botmayank/haathi_cam/kicad/README.md

# haathi_cam
NXP i.MXRT1050 based camera to set up an early warning system for villages detecting wild elephants in rural India.

This folder contains KiCAD hardware design files.
