botmayank/haathi_cam/docs/haathi_block.png

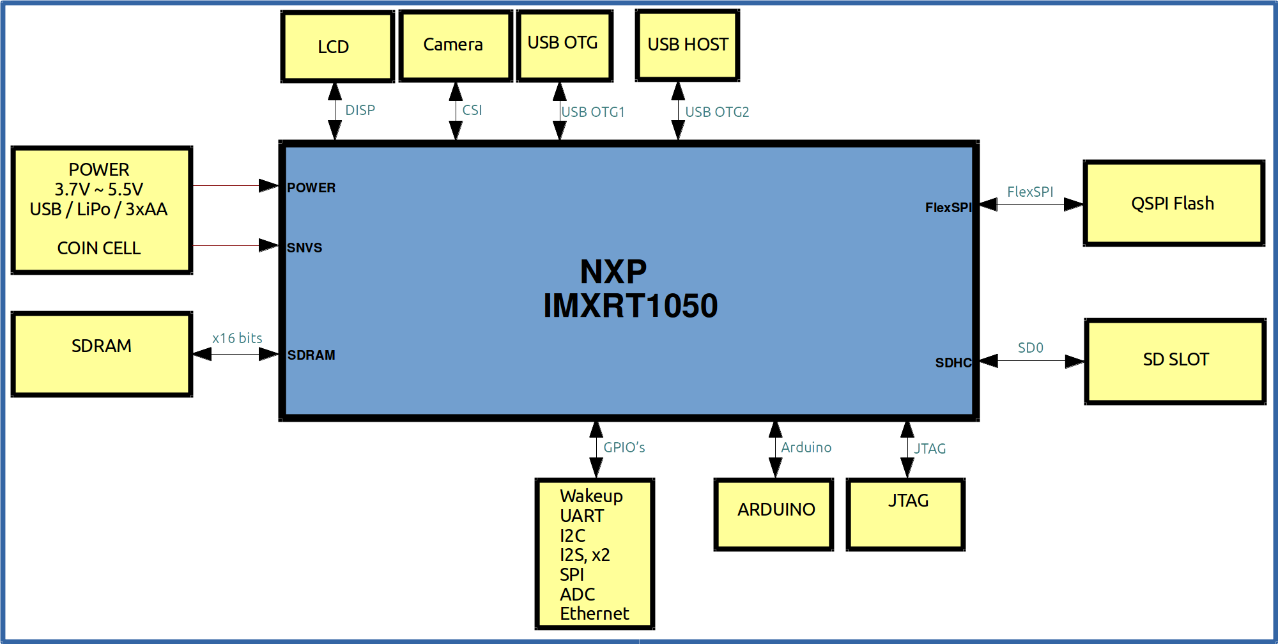
docs/haathi_block.png
