botmayank/haathi_cam/kicad/pdf/haathi.pdf

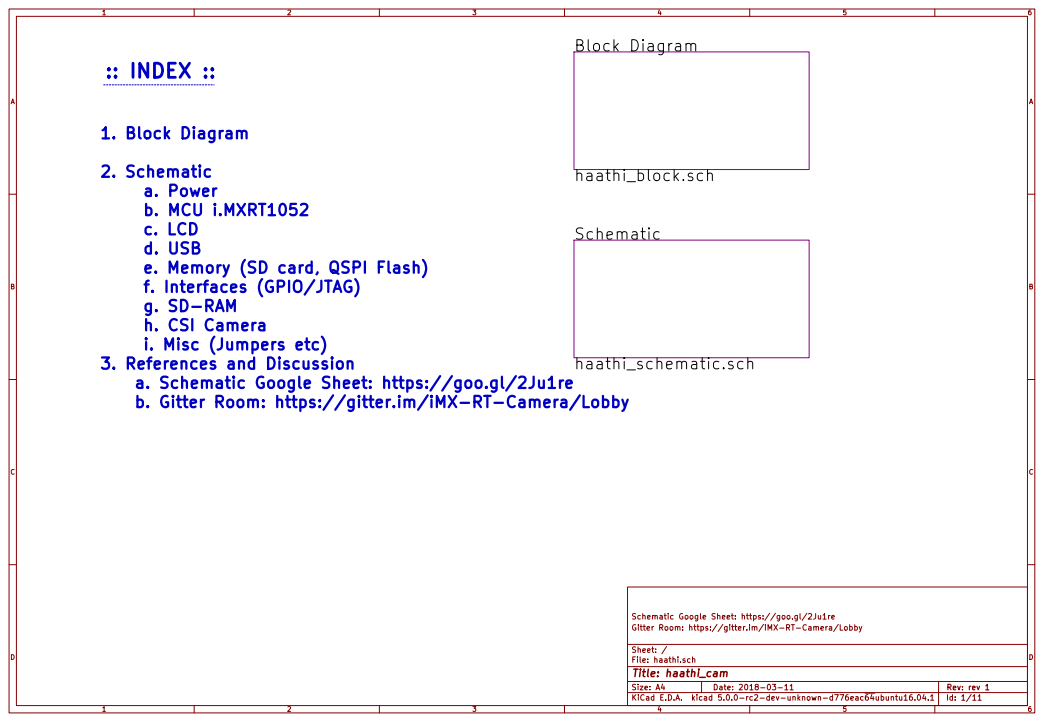
[picture p2: page 1]

2. Schematic
a. Power
b. MCU i.MXRT1052
c. LCD
d. USB
e. Memory (SD card, QSPI Flash)
f. Interfaces (GPIO/JTAG)
g. SD-RAM
h. CSI Camera
i. Misc (Jumpers etc)
3. References and Discussion
a. Schematic Google Sheet: https://goo.gl/2Ju1re
b. Gitter Room: https://gitter.im/iMX-RT-Camera/Lobby

Schematic Google Sheet: https://goo.gl/2Ju1re
File: haathi.sch Sheet: / Gitter Room: https://gitter.im/iMX-RT-Camera/Lobby

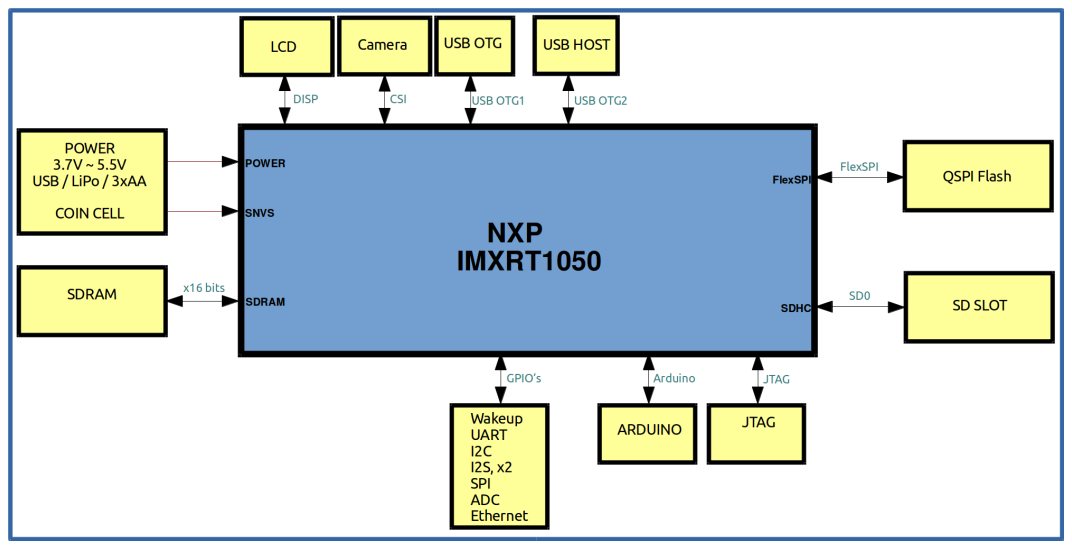
[picture p3: page 2]

Schematic Google Sheet: https://goo.gl/2Ju1re
Gitter Room: https://gitter.im/iMX-RT-Camera/Lobby

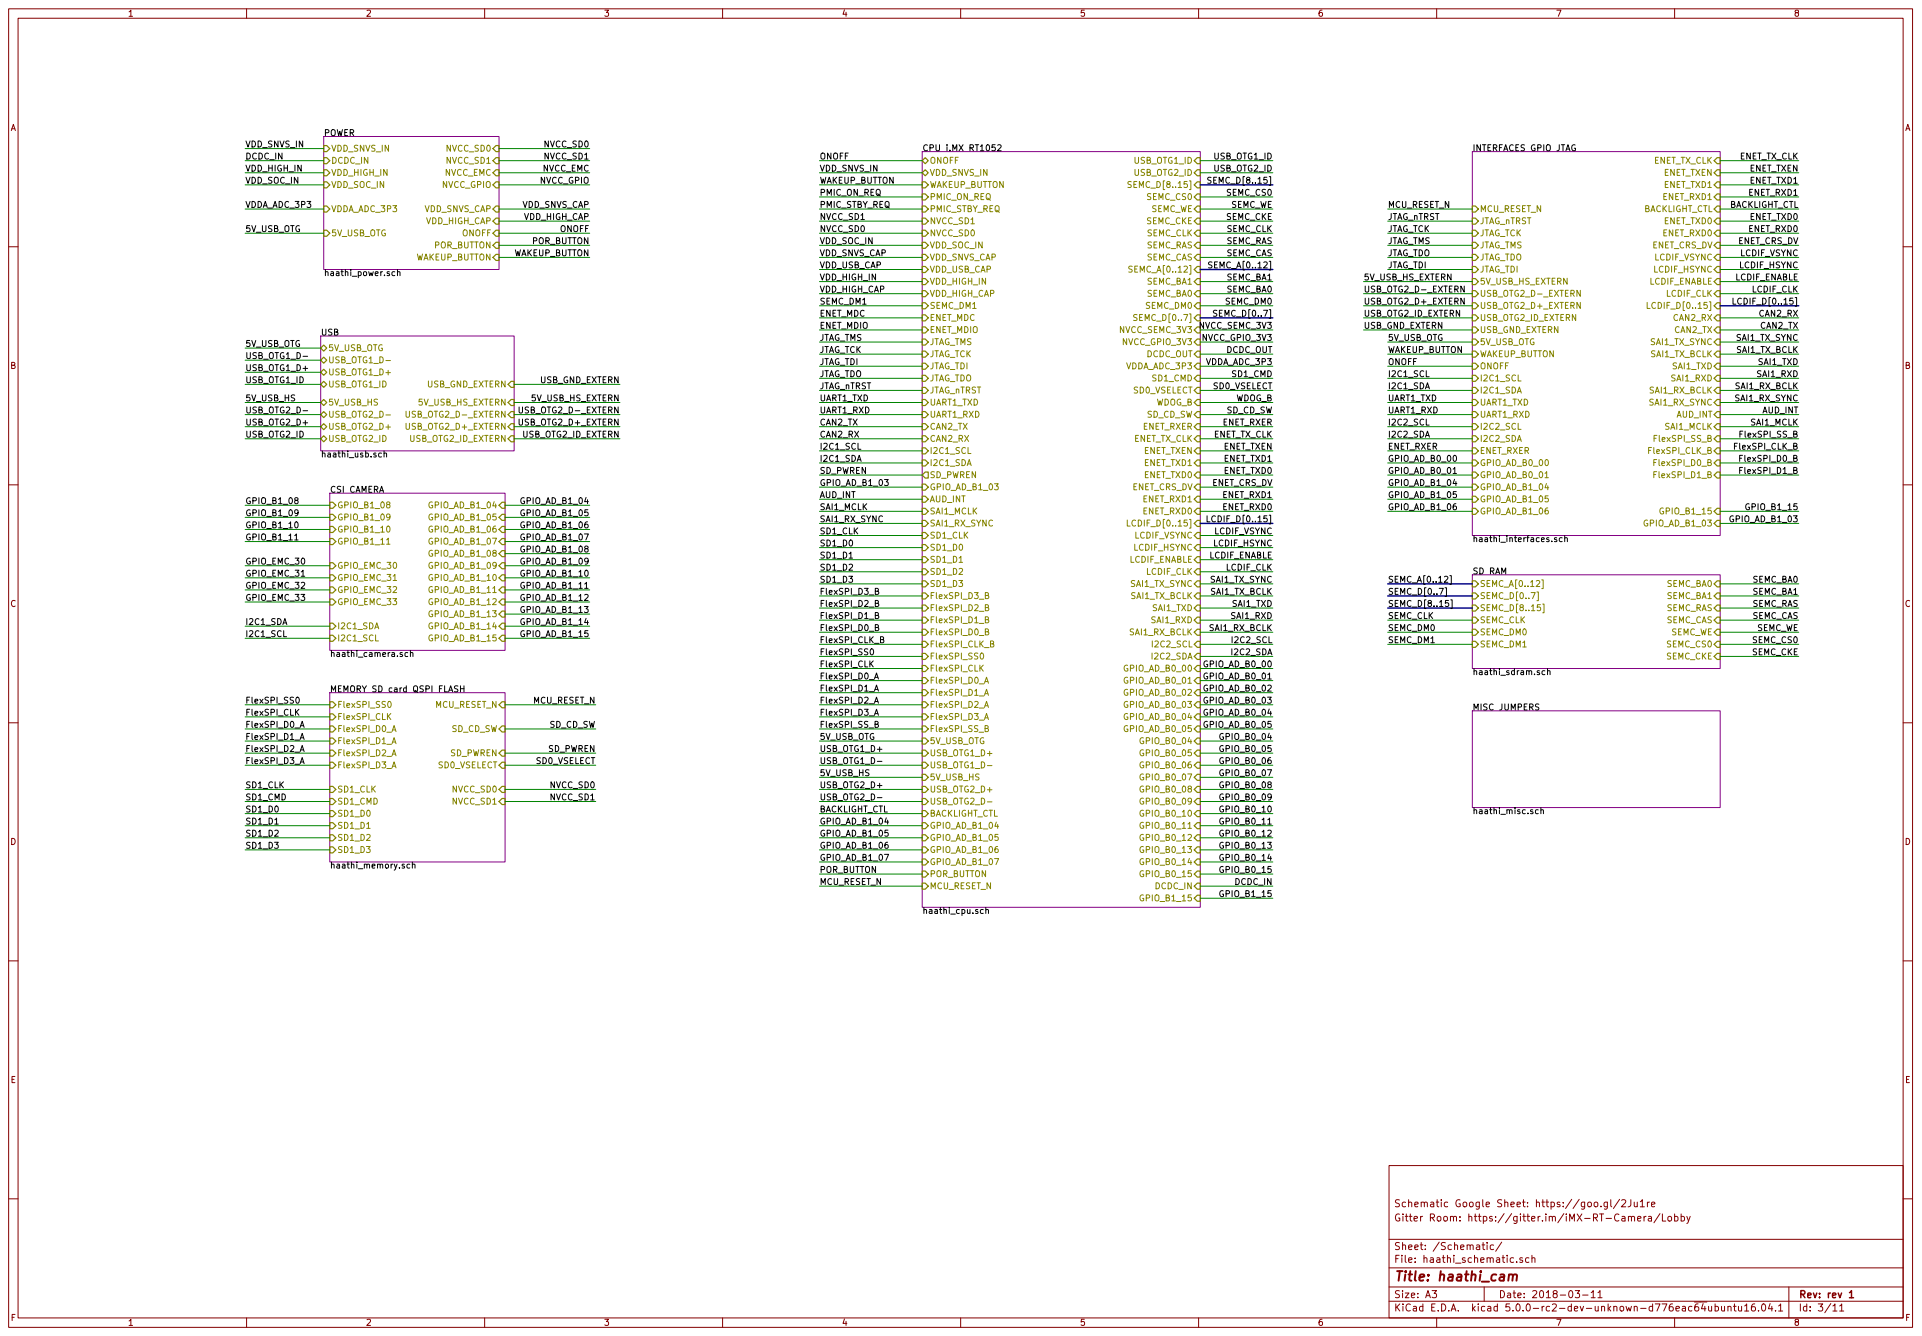
[picture p4: page 3]

GPIO_B1_15 MEMORY SD card QSPI FLASH
FlexSPI_SS0 FlexSPI_CLK

Schematic Google Sheet: https://goo.gl/2Ju1re
File: haathi_schematic.sch Sheet: /Schematic/ Gitter Room: https://gitter.im/iMX-RT-Camera/Lobby

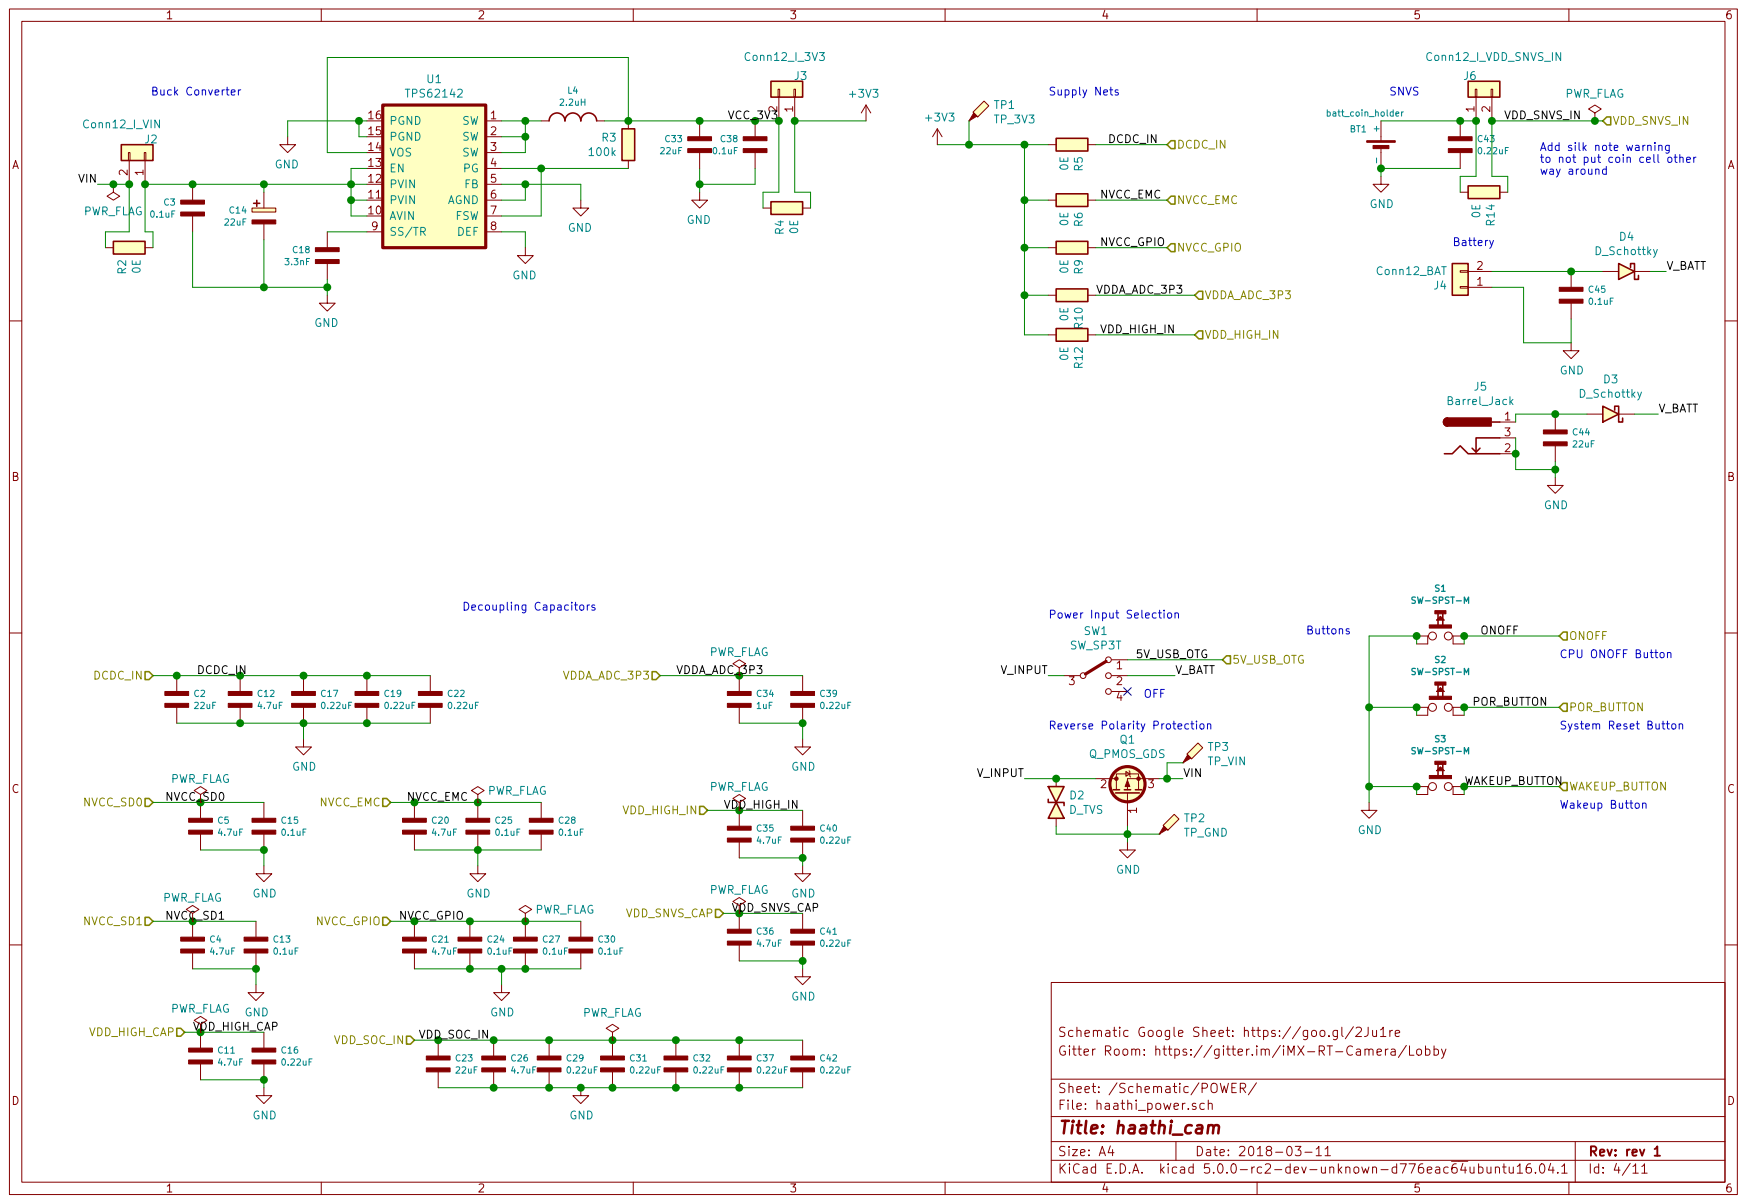
[picture p5: page 4]

Add silk note warning
to not put coin cell other
way around

Schematic Google Sheet: https://goo.gl/2Ju1re
File: haathi_power.sch Sheet: /Schematic/POWER/ Gitter Room: https://gitter.im/iMX-RT-Camera/Lobby

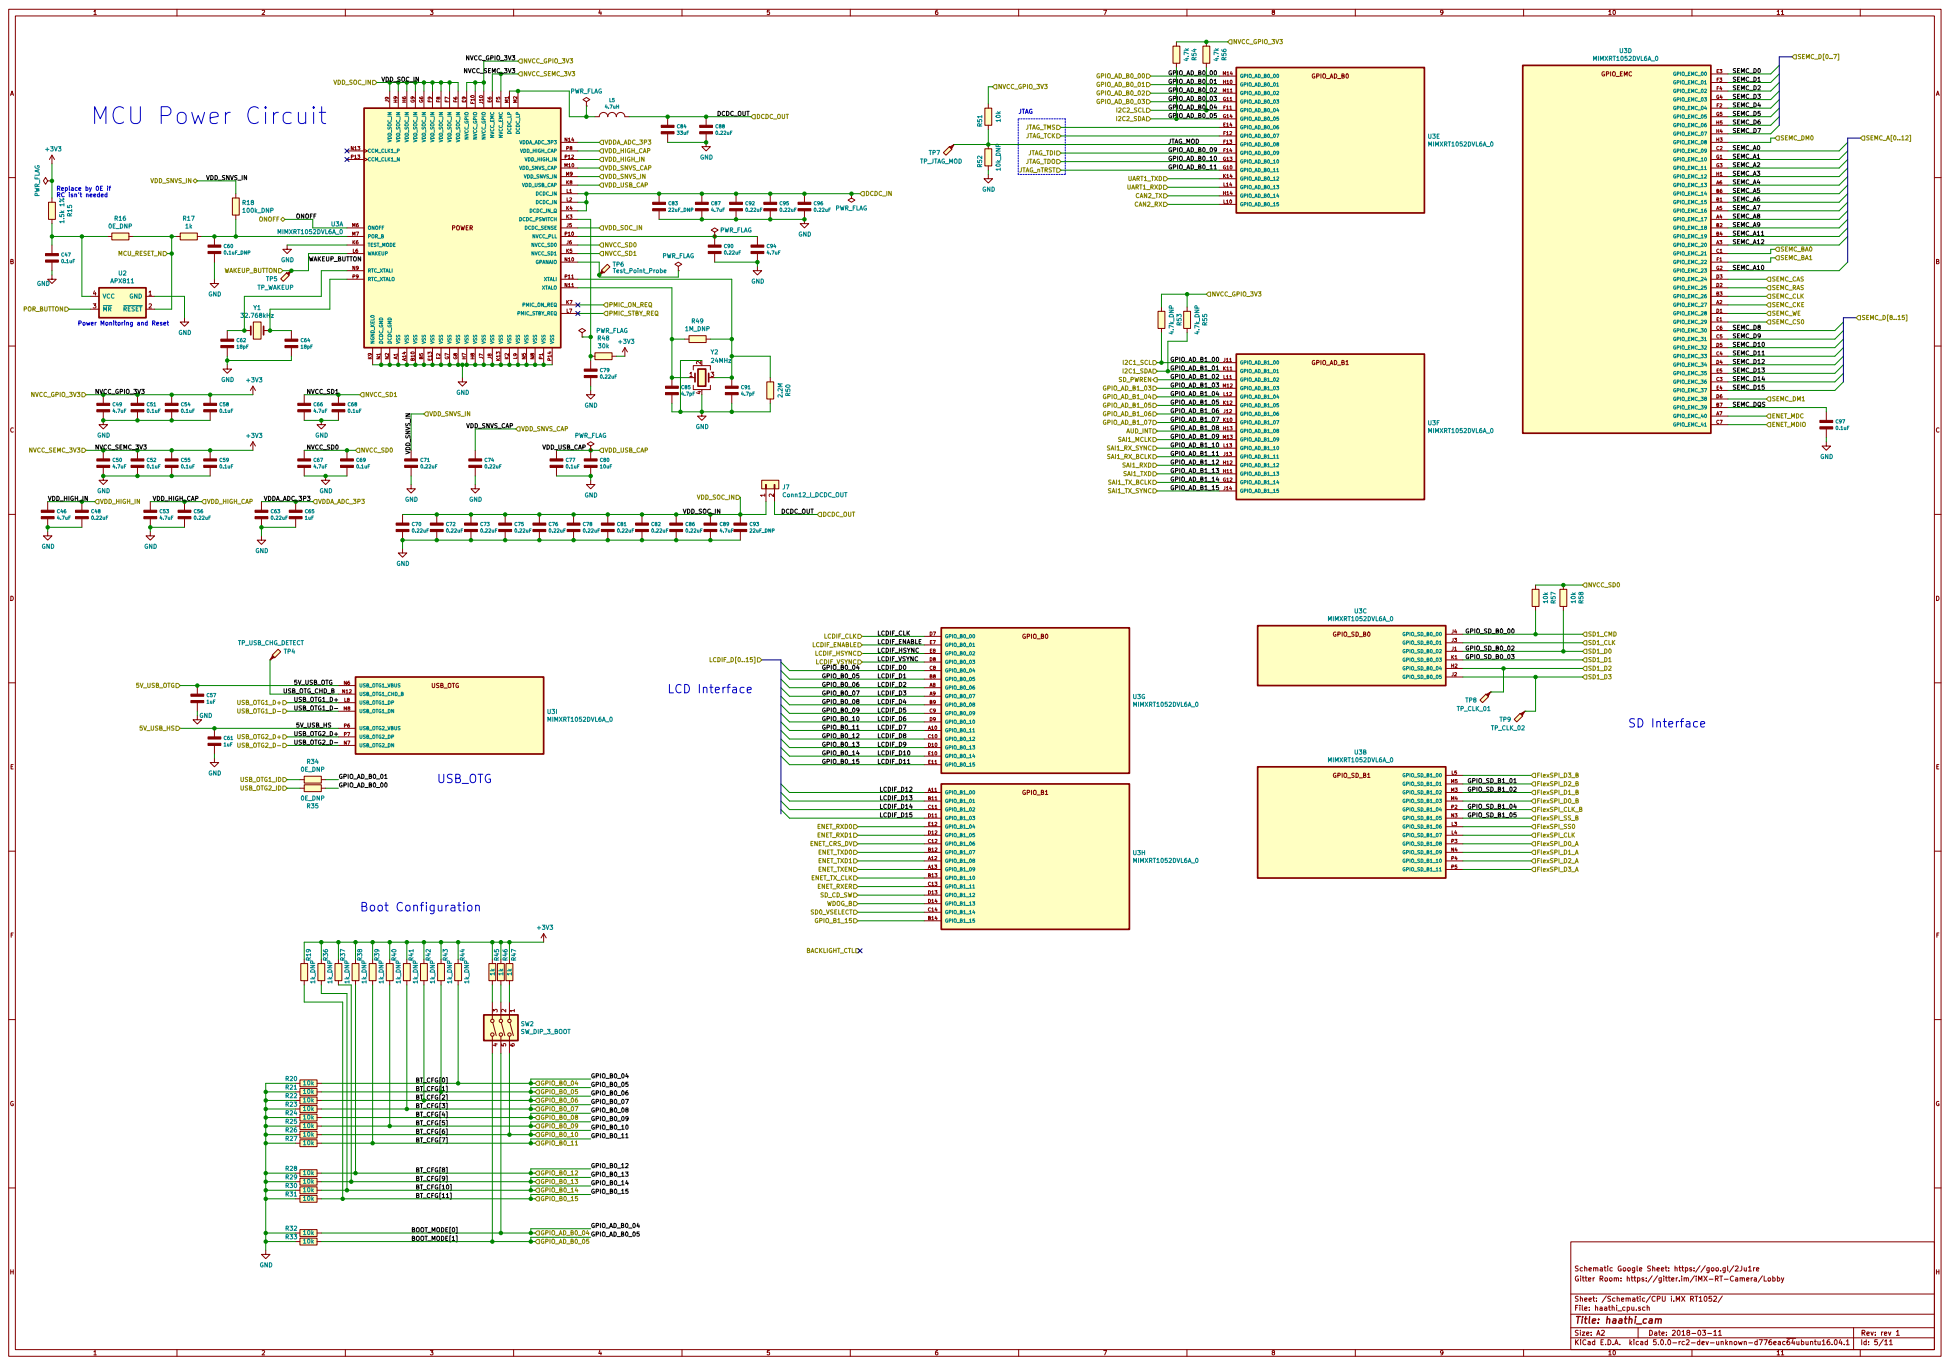
[picture p6: page 5]

Power Monitoring and Reset

Schematic Google Sheet: https://goo.gl/2Ju1re
File: haathi_cpu.sch Sheet: /Schematic/CPU i.MX RT1052/ Gitter Room: https://gitter.im/iMX-RT-Camera/Lobby

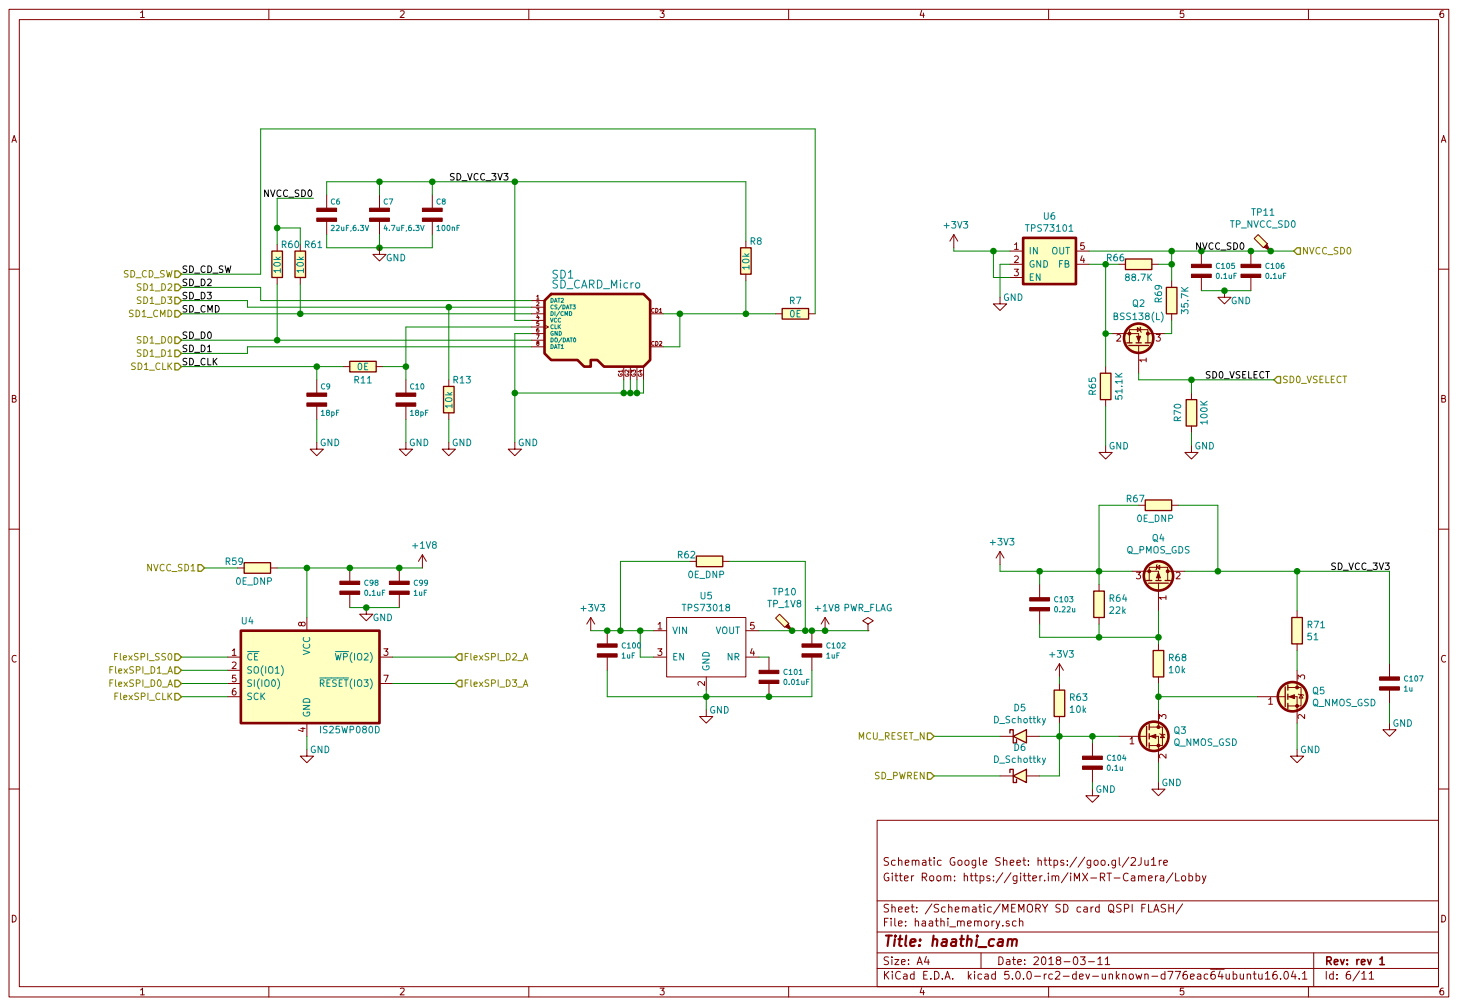
[picture p7: page 6]

2 EN 3 NR 4 VOUT 5 U5 TPS73018 GND

4 SI(IO0) 5 SCK 6 RESET(IO3) 7 VCC

Schematic Google Sheet: https://goo.gl/2Ju1re
Gitter Room: https://gitter.im/iMX-RT-Camera/Lobby

Sheet: /Schematic/MEMORY SD card QSPI FLASH/
File: haathi_memory.sch
Id: 6/11 Title: haathi_cam

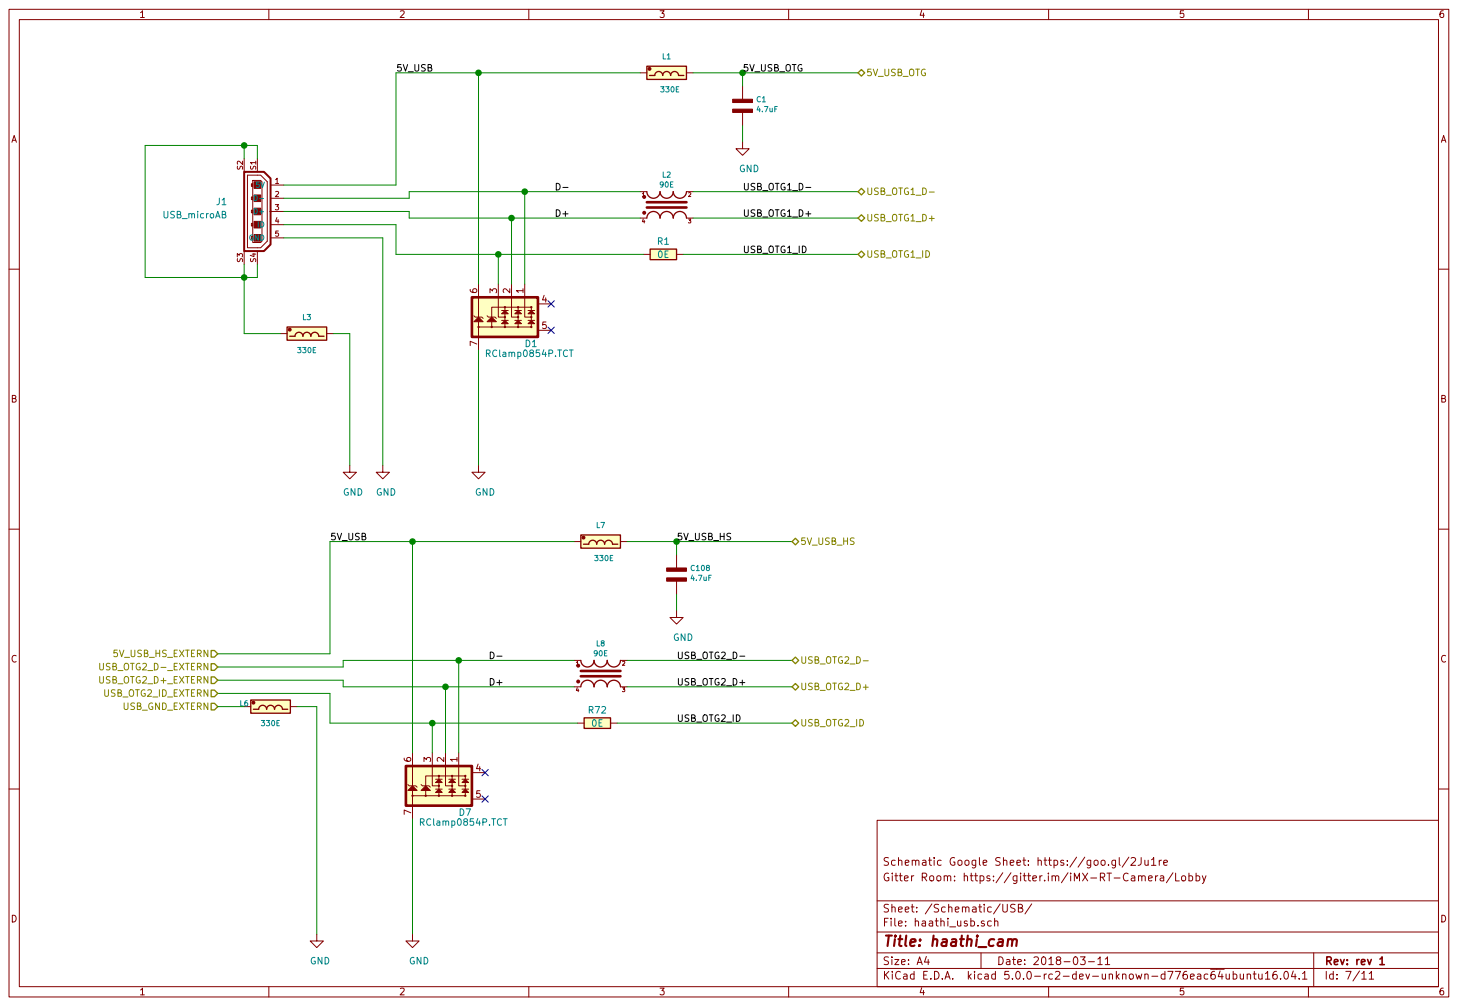
[picture p8: page 7]

Schematic Google Sheet: https://goo.gl/2Ju1re
File: haathi_usb.sch Sheet: /Schematic/USB/ Gitter Room: https://gitter.im/iMX-RT-Camera/Lobby

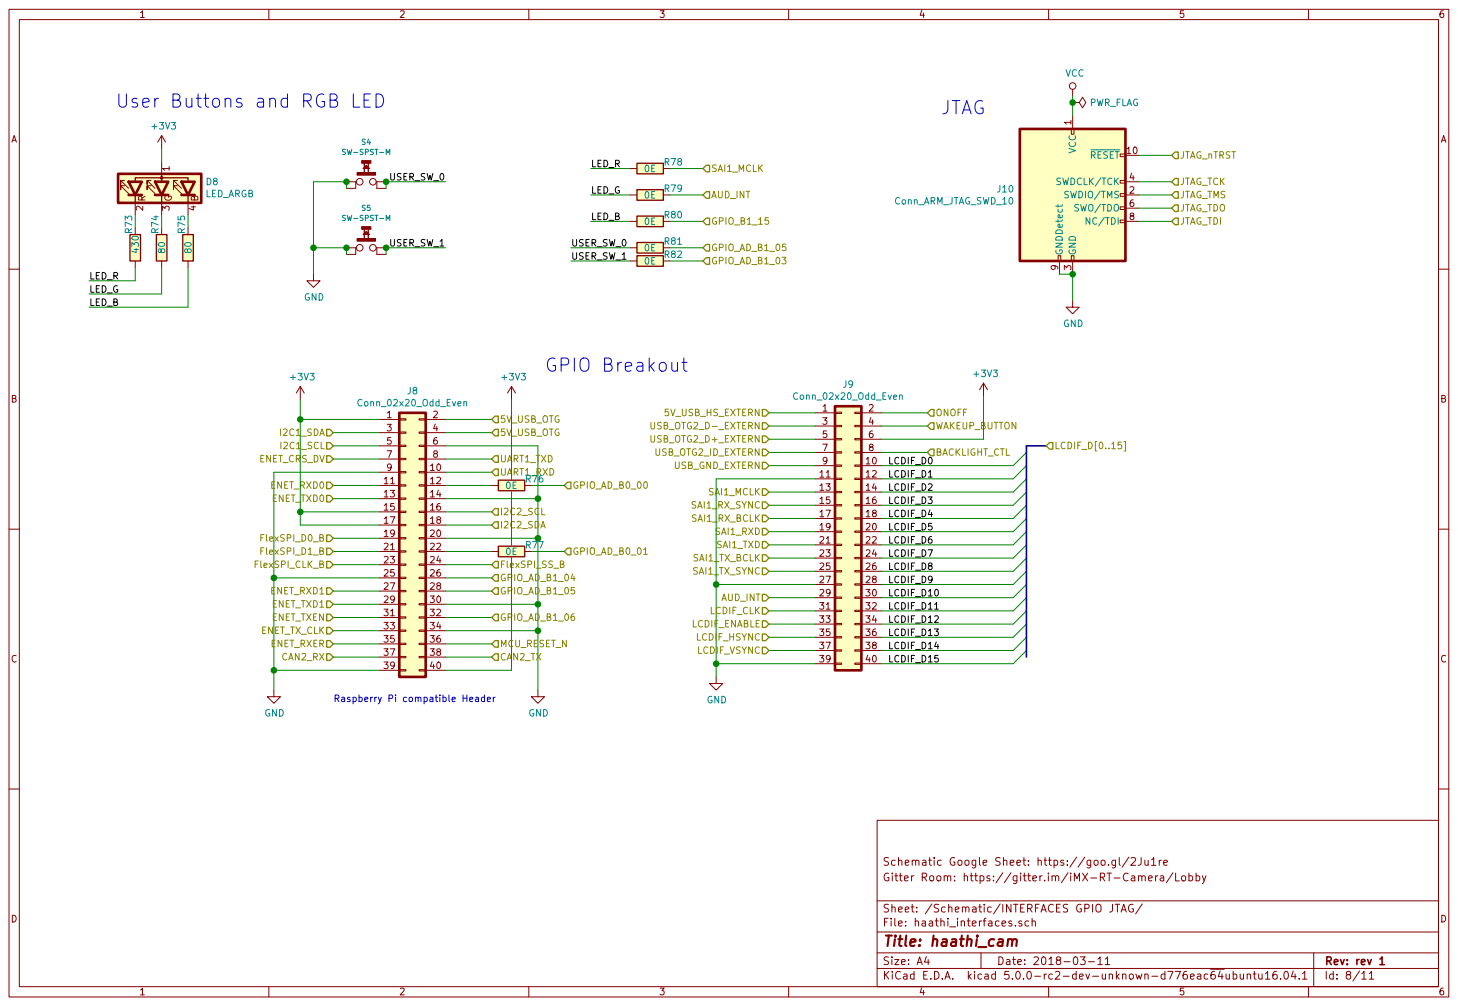
[picture p9: page 8]

1 RESET 10 SWDIO/TMS 2 GND

3 SWDCLK/TCK 4 SWO/TDO 6 NC/TDI 8 GNDDetect 9

Raspberry Pi compatible Header

Schematic Google Sheet: https://goo.gl/2Ju1re
File: haathi_interfaces.sch Sheet: /Schematic/INTERFACES GPIO JTAG/ Gitter Room: https://gitter.im/iMX-RT-Camera/Lobby

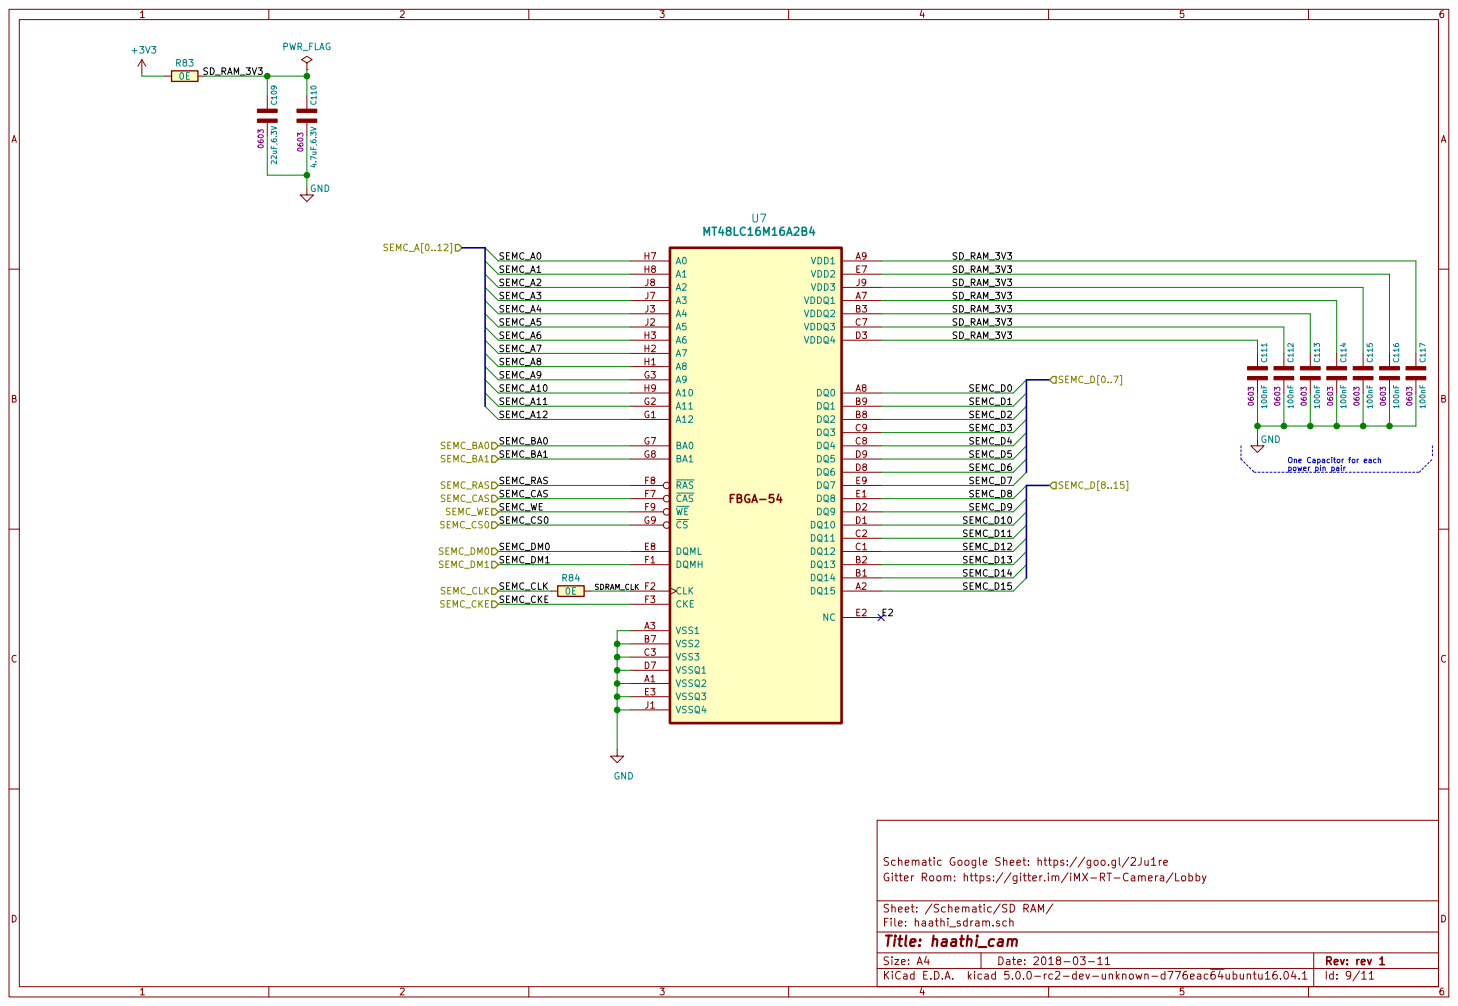
[picture p10: page 9]

Schematic Google Sheet: https://goo.gl/2Ju1re FBGA-54

File: haathi_sdram.sch Sheet: /Schematic/SD RAM/ Gitter Room: https://gitter.im/iMX-RT-Camera/Lobby

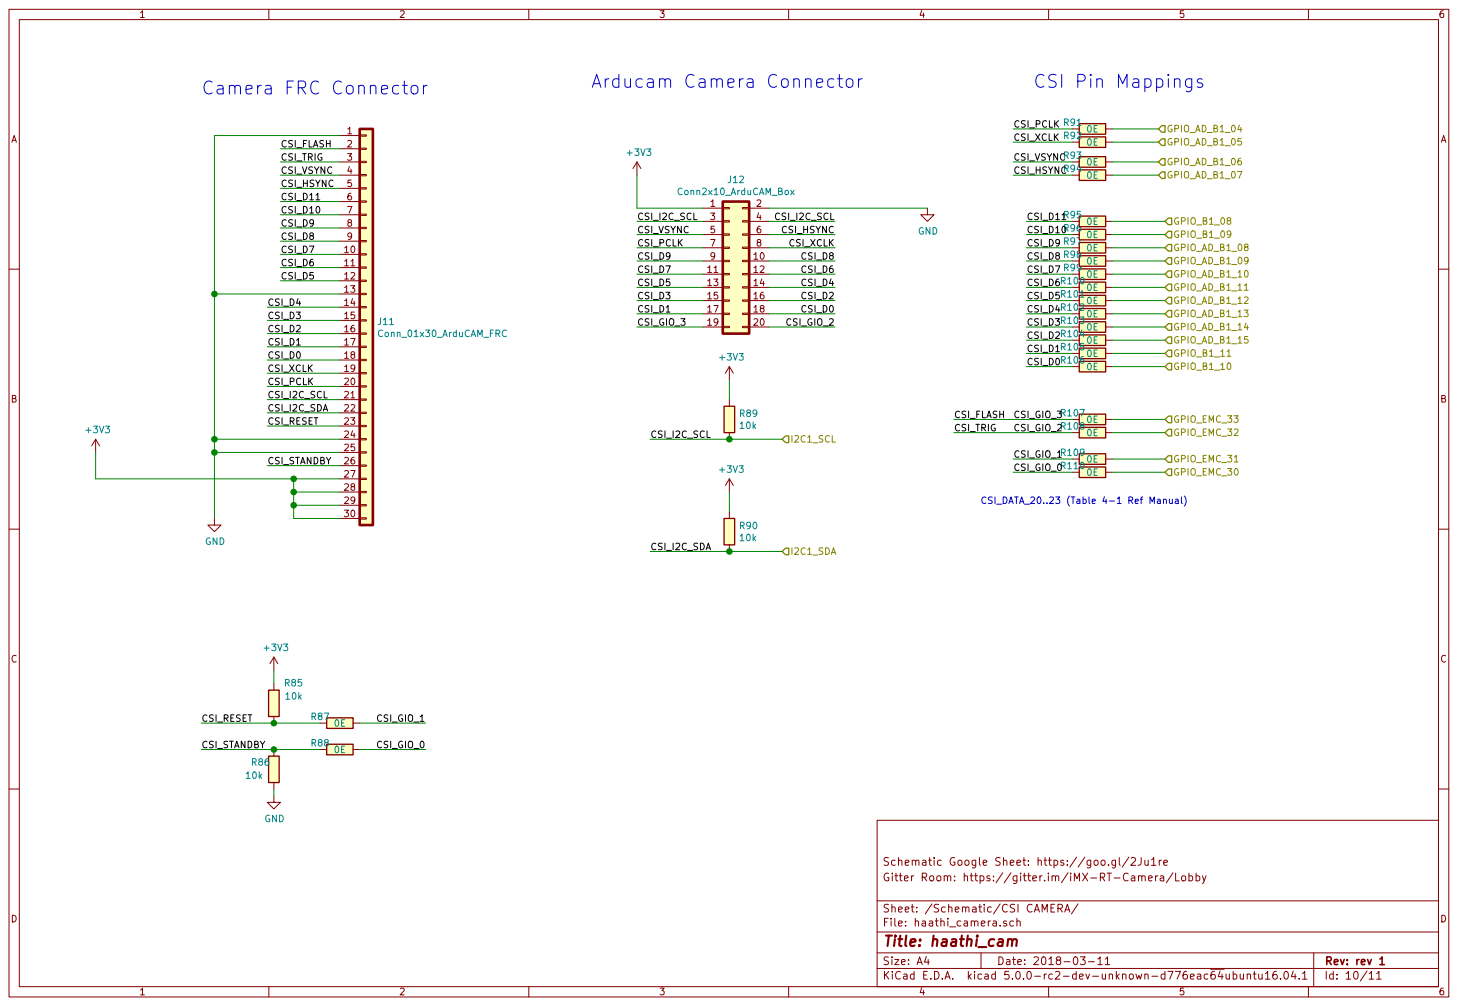
[picture p11: page 10]

Schematic Google Sheet: https://goo.gl/2Ju1re
File: haathi_camera.sch Sheet: /Schematic/CSI CAMERA/ Gitter Room: https://gitter.im/iMX-RT-Camera/Lobby

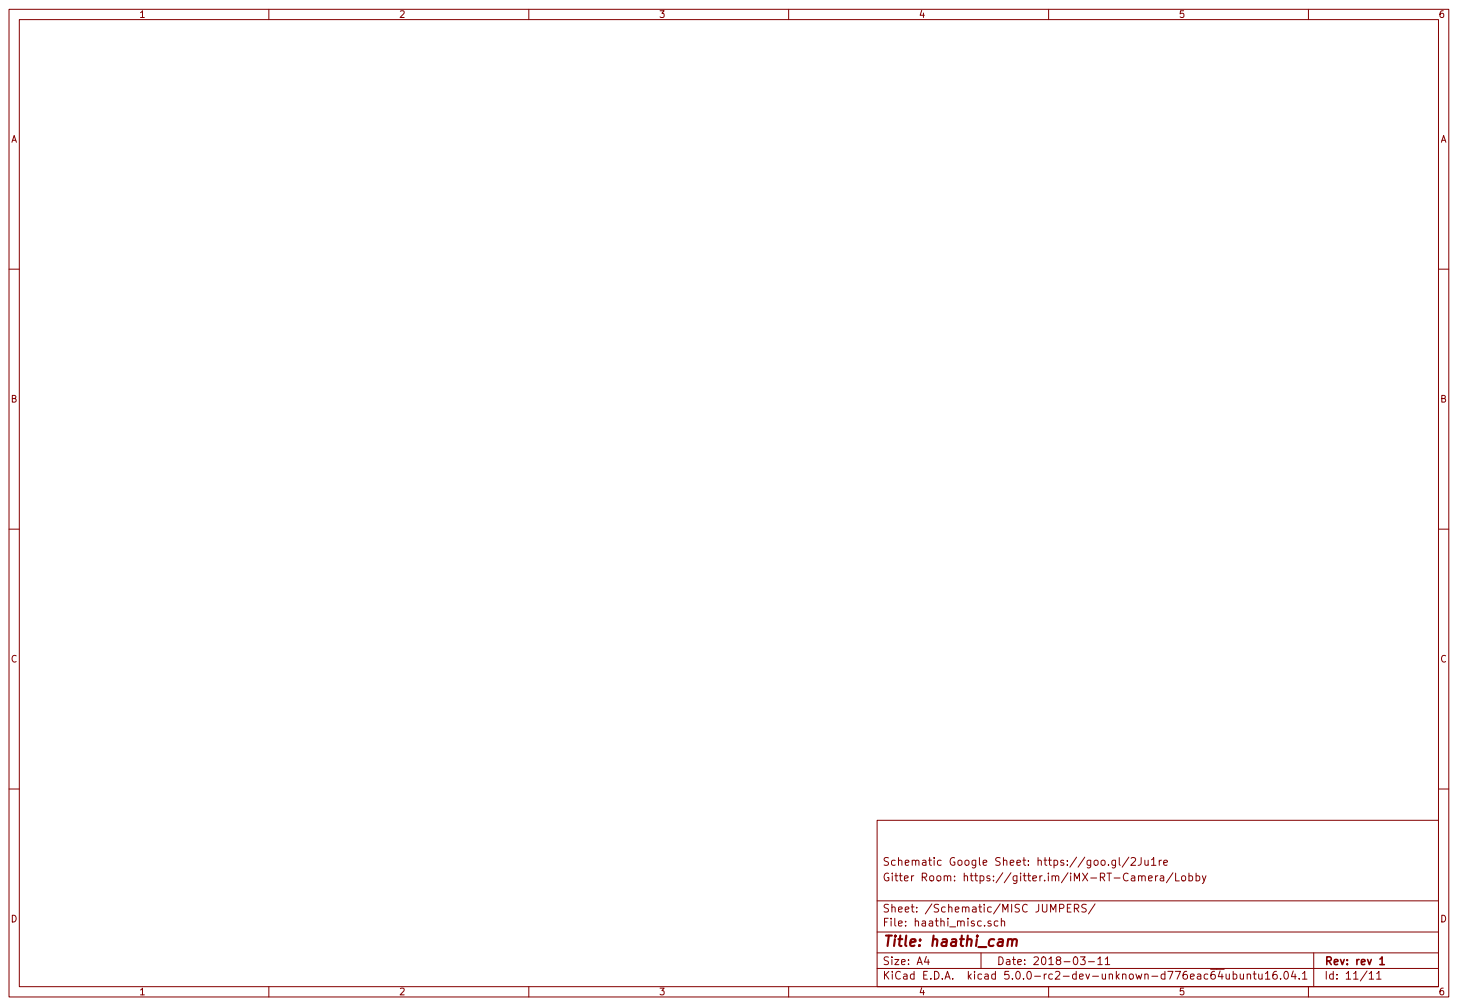
[picture p12: page 11]

Schematic Google Sheet: https://goo.gl/2Ju1re
File: haathi_misc.sch Sheet: /Schematic/MISC JUMPERS/ Gitter Room: https://gitter.im/iMX-RT-Camera/Lobby
