botmayank/haathi_cam/(commit log)

2017-12-27 Added EVK Design files and potential Camera ov5647 datasheet
2018-01-04 added folder structure and i.MXRT1050 libraries
    [haathi.kicad_pcb, haathi.sch]
2018-01-04 added a multi unit version of i.MX schematic symbol
    [haathi.sch]
2018-01-05 added BGA routing guides
    [haathi.kicad_pcb, haathi.sch]
2018-01-06 added BGA design guides
    [haathi.kicad_pcb]
2018-01-06 added some schematic symbols to lib
    [block.sch, haathi.sch, schematic.sch]
2018-01-07 added block diagram
    [block.sch, haathi.sch]
2018-01-20 created schematic structure
    [haathi.sch, haathi_block.sch, haathi_camera.sch, haathi_cpu.sch, haathi_interfaces.sch, haathi_lcd.sch, haathi_memory.sch, haathi_misc.sch]
2018-01-26 Claimed sheets and cloned schem sym lib
    [haathi_schematic.sch]
2018-01-28 Added power circuits for buck converter and snvs
    [_saved_haathi_power.sch, haathi_block.sch, haathi_schematic.sch]
2018-01-28 Anool, USB sheet
    [_saved_haathi_power.sch, haathi_block.sch, haathi_schematic2.sch, haathi_usb.sch]
2018-01-28 gitignore modified
    [haathi_block.sch, haathi_power.sch, haathi_schematic.sch, haathi_usb.sch]
2018-01-28 Anool, Memory schematic WIP
    [haathi_memory.sch, haathi_power.sch]
2018-01-31 Mayank, Power added decoupling and buttons
    [haathi_power.sch]
2018-02-03 Mayank, power ckt, corrections and reset ckt
    [haathi_power.sch]
2018-02-03 Mayank, reverse polarity protection and test points
    [haathi_camera.sch, haathi_power.sch]
2018-02-11 Mayank, CPU Sheet init and supervisor IC
    [haathi_cpu.sch]
2018-02-11 Mayank, Added current measurement jumpers on power sheet
    [haathi_power.sch]
2018-02-11 Mayank, CPU Power connections
    [haathi_cpu.sch]
2018-02-11 Mayank, CPU finished GPIO EMC block
    [haathi_cpu.sch]
2018-02-11 Mayank, CPU, completed GPIO_AD_B1
    [haathi_cpu.sch]
2018-02-11 Mayank, CPU added GPIO_B0 and GPIO_B1
    [haathi_cpu.sch]
2018-02-11 Mayank, CPU Sheet done, added USB OTG pins
    [haathi_cpu.sch]
2018-02-11 Mayank, added BootCFG with dipswitch to CPU sheet
    [haathi_cpu.sch]
2018-02-15 Mayank, Camera sheet done with Arducam and FRC header
    [haathi_camera.sch]
2018-02-15 Mayank, Power sheet: Added 0Ohm resistors in parallel to current measurement jumpers
    [haathi_power.sch]
2018-02-15 Mayank, Power: added TVS Diode to V_INPUT
    [haathi_power.sch]
2018-02-15 Mayank, GPIO and Interfaces: Added JTAG, RGB LED, Buttons and GPIO blank headers
    [haathi_interfaces.sch]
2018-02-17 Camera modified FRC connector and D9 to D0 on Box header
    [haathi_camera.sch]
2018-02-17 Added datasheets for Camera FRC, JTAG, RGB LED
2018-02-19 USB, added host ckt with components
    [haathi_usb.sch]
2018-02-19 Interfaces, added USB External signals
    [haathi_interfaces.sch]
2018-02-19 Overview sheet, added Google Sheet and Gitter links
    [haathi.sch]
2018-02-19 Renamed USER_BUTTON to WAKEUP_BUTTON
    [haathi_cpu.sch, haathi_power.sch]
2018-02-19 Removed LCD sheet block from main schematic
    [haathi_schematic.sch]
2018-02-27 Mayank, Power sheet:Flipped Buck ckt, changed conn vals, 0Ohm to 0E on power sheet
    [haathi_power.sch]
2018-02-27 Mayank, CPU sheet, replaced VCC with 3V3 power sym, removed JTAG alt pins, added sheet local labels
    [haathi_cpu.sch]
2018-02-27 Mayank, USB: corrected local labels for USB HS
    [haathi_usb.sch]
2018-02-27 Mayank, SD card: Removed Transistor on Card Detect pin
    [haathi_memory.sch]
2018-02-27 Mayank, Camera: Renamed arducam connectors
    [haathi_camera.sch]
2018-03-09 Mayank, Camera, replaced VCC with +3V3 Flags
    [haathi_camera.sch]
2018-03-10 Mayank, added QSPI Flash symbol and connections
    [haathi_memory.sch]
2018-03-10 Mayank, added TLV70218 LDO for Flash
    [haathi_memory.sch]
2018-03-10 Mayank, added SD Card variable voltage regulator ckt and changed supply to NVCC_SD0
    [haathi_memory.sch]
2018-03-10 Mayank, added datasheets for memory sheet voltage regulators
2018-03-11 Anool, updated SD-RAM schematic
    [haathi.sch, haathi_block.sch, haathi_camera.sch, haathi_cpu.sch, haathi_interfaces.sch, haathi_memory.sch, haathi_misc.sch, haathi_power.sch]
2018-03-11 Mayank, added RPi3 interfaces and haathi periph
    [haathi_cpu.sch, haathi_interfaces.sch]
2018-03-11 Mayank, corrected bus labels in interfaces and cpu
    [haathi_cpu.sch, haathi_interfaces.sch]
2018-03-12 Edited NVCC_SD0 label on memory sheet TPS73101 output
    [haathi_memory.sch]
2018-03-25 Memory sheet, changed supply of SD to 3V3 and removed extra GPIO tap to SD_CLK
    [haathi_memory.sch]
2018-03-25 power: Edited V_USB label to 5V_USB_OTG
    [haathi_power.sch]
2018-03-25 power: added note for reverse pol Coin Cell to go on silk
    [haathi_power.sch]
2018-03-25 memory: Changed LDO to TPS73018 w/ bypass 0E_DNP
    [haathi_memory.sch]
2018-03-25 interfaces, cpu: I2C1 w/o pull-ups and I2C2 w/ pull-ups added, ADC pins broken out to RasPi header
    [haathi_cpu.sch, haathi_interfaces.sch]
2018-03-25 interfaces: conencted RGB LED and Switches to GPIO pins
    [haathi_interfaces.sch]
2018-03-25 schematic: changed overall sheet to A3 for inter-sheet wiring
    [haathi_camera.sch, haathi_cpu.sch, haathi_interfaces.sch, haathi_memory.sch, haathi_misc.sch, haathi_power.sch, haathi_schematic.sch, haathi_sdram.sch]
2018-03-25 interfaces: Backlight ctl moved to second header, added 3v3
    [haathi_interfaces.sch]
2018-03-25 interfaces: RGB pins
    [haathi_interfaces.sch]
2018-03-25 haathi_mayank.lib: Added GND, 1V8, and 3V3 symbols
2018-03-27 Update SD Card voltage level select circuit
    [haathi_memory.sch]
2018-03-27 Adds couple of camera applications guides
2018-03-27 Migration to A1 needs RC delay for PSWITCH.
    Change the 0E to 30k for the RC filter to delay the PSWITCH signal as compared to DCDC_IN
    [haathi_cpu.sch]
2018-03-27 Add the 0.1 decoupling/RC filter cap to the voltage detector. Gone are SPDIF In and Out, one of them used for SD_PWREN and other a general GPIO.
    [haathi_cpu.sch]
2018-03-27 Add the SD card power control MOS switch circuitry
    [haathi_memory.sch]
2018-03-28 Removes the APX811 from the power sheet, as its shifted to CPU sheet
    [haathi_power.sch]
2018-03-28 Removes the redundant APX809 voltage detector and its replaced by APX811, which receives input from a reset button.
    [haathi_cpu.sch]
2018-04-10 Imported all hierarchical labels on top sheet
    [haathi_camera.sch, haathi_cpu.sch, haathi_interfaces.sch, haathi_memory.sch, haathi_misc.sch, haathi_power.sch, haathi_schematic.sch, haathi_sdram.sch]
2018-04-10 Haathi schematic imported CPU pins
    [haathi_schematic.sch]
2018-04-14 Few local labels made hierarchical and VCC is now from 3V3 as opposed to DCDC_IN
    [haathi_sdram.sch]
2018-04-14 NVCC_SD0 and NVCC_SD1 are not from 3V3. Flag and GND connected properly.
    [haathi_power.sch]
2018-04-14 NVCC_SD0 and NVCC_SD1 are generated in this sheet now
    [haathi_memory.sch]
2018-04-14 Makes the internal LED and switch labels as local not hierarchical
    [haathi_interfaces.sch]
2018-04-14 Make the internal camera signals local not hierarchical
    [haathi_camera.sch]
2018-04-14 Replaces 3V3 with DCDC_IN for the DCDC of the imxrt. Adds MCU_RESET_N for the SD card power off.
    [haathi_cpu.sch]
2018-04-17 Top schematic, re-arranged CPU block pins and added wires
    [haathi_camera.sch, haathi_cpu.sch, haathi_interfaces.sch, haathi_memory.sch, haathi_power.sch, haathi_schematic.sch, haathi_sdram.sch]
2018-04-17 CPU, Interfaces, SDRAM top sheet wiring done, CPU bootcfg local labels fixed
    [haathi_cpu.sch, haathi_interfaces.sch, haathi_schematic.sch]
2018-04-18 haathi_schematic: Rearange hier-labels and complete schematic wiring
    [haathi_schematic.sch]
2018-04-19 Cleanup of top level local labels
    [haathi_cpu.sch, haathi_memory.sch, haathi_schematic.sch, haathi_sdram.sch]
2018-04-19 USB_OTG1_ID and USB_OTG2_ID pins: Add to CPU sheet
    Add configurability on the way these pins can be used, using 0R
    resistors.
    [haathi_cpu.sch, haathi_interfaces.sch, haathi_schematic.sch]
2018-04-19 Wired hierarchical label on interfaces sheet for USB_OTG
    [haathi_cpu.sch, haathi_interfaces.sch, haathi_schematic.sch]
2018-04-19 Rearrange buttons and LED pin connections
    LED pins go to PWM pins
    Switches go to previously SPDIF_IN and OUT pins
    FlexSPI 2 pins freed up
    [haathi_cpu.sch, haathi_interfaces.sch, haathi_schematic.sch]
2018-04-19 JTAG_MOD pullup and DNP pull down
    [haathi_cpu.sch]
2018-04-19 Added MCU_RESET_N to interfaces
    [haathi_cpu.sch, haathi_interfaces.sch, haathi_schematic.sch]
2018-04-19 Annotated schematic
    [haathi_camera.sch, haathi_cpu.sch, haathi_interfaces.sch, haathi_memory.sch, haathi_power.sch, haathi_sdram.sch, haathi_usb.sch]
2018-04-21 ERC pass 1: Check and resolve the errors
    [haathi_camera.sch, haathi_cpu.sch, haathi_interfaces.sch, haathi_memory.sch, haathi_misc.sch, haathi_power.sch, haathi_schematic.sch, haathi_sdram.sch]
2018-04-21 Update generated schematic PDF
2018-04-21 Relabelling of sheets after regenerating PDF
    [haathi_interfaces.sch, haathi_memory.sch, haathi_misc.sch, haathi_sdram.sch, haathi_usb.sch]
2018-04-29 QuadSPI part updated to 3V supply one, removed the 1.8V regulator for it.
    Updated the pin number of SD card and Quad SPI to the format as per the new pin mapping.
    [haathi_memory.sch]
2018-04-29 Updated the pin numbers to the camera as per the format of the new pin mapping.
    [haathi_camera.sch]
2018-04-29 GPIO namings as per the datasheet except for JTAG, LCD and SDRAM. Pull up/downs in the respective peripheral sheet.
    [haathi_cpu.sch]
2018-04-29 SD Card, D3, Pull down, changed to DNP
    [haathi_memory.sch]
2018-04-29 Interfaces, reconnected I2C, RGB LED, CAN
    [haathi_interfaces.sch]
2018-05-09 Interfaces, re-connected SPI, ADC, Switch GPIO
    [haathi_camera.sch, haathi_cpu.sch, haathi_interfaces.sch, haathi_memory.sch, haathi_misc.sch, haathi_power.sch, haathi_schematic.sch, haathi_sdram.sch]
2018-05-09 Symbol Lib, added 4 and 8 pin Resistor Packs
2018-05-09 Re-wired CSI/SAI interface pins to headers
    [haathi_interfaces.sch]
2018-05-09 Interfaces, added 4.7k DNP pull ups to I2C3 bus
    [haathi_interfaces.sch]
2018-05-10 Switch RGB LED from GPIO_AD_B0_01 to GPIO_SD_B1_02
    GPIO_AD_B0_01 was already used for LED backlight
    [haathi_interfaces.sch]
2018-05-17 Updated interfaces hierarchical labels to top level schematic
    [haathi_schematic.sch]
2018-05-27 Added a symbol for the TPD4S012 TVS diode IC for USB port protection
2018-05-27 Removes the ID label for USB1 as its only in device mode.
    The TCS diode for USB port protection is updated to TPD4S012
    [haathi_usb.sch]
2018-05-27 Clean up of USB OTG labels
    [haathi_cpu.sch]
2018-05-27 Changes OFF to mid pin in SP3T switch
    Changes dual schottky diode to a single package.
    [haathi_power.sch]
2018-05-27 Corrects error in naming a label
    [haathi_memory.sch]
2018-05-27 Updates the USB OTG connections for OTG2 on the shield
    [haathi_interfaces.sch]
2018-05-27 Fixes the naming of the hierarchical labels for memory, USB, interfaces and camera sheets
    [haathi_schematic.sch]
2018-06-04 Cleaned up CPU pins on top sheet
    [haathi_schematic.sch]
2018-06-04 Cleaned up pins of all sheets on top sch sheet
    [haathi_camera.sch, haathi_cpu.sch, haathi_interfaces.sch, haathi_memory.sch, haathi_misc.sch, haathi_power.sch, haathi_sdram.sch, haathi_usb.sch]
2018-06-11 Changed dual schottky diode from device library to Haati one
    [haathi_power.sch]
2018-06-11 Added dual common cathode diode part to Haathi library.
2018-07-01 Complete annotation
    [haathi_camera.sch, haathi_cpu.sch, haathi_interfaces.sch, haathi_memory.sch, haathi_misc.sch, haathi_power.sch, haathi_schematic.sch, haathi_sdram.sch]
2018-07-01 haathi.lib: Fix TPD4S012 schematic symbol
2018-07-01 ERC fix pass 2, connect ENET_* PINS to header
    [haathi_interfaces.sch]
2018-07-04 Added other footprints
2018-07-13 SOT family footprints for the various MOSFETs and TPS73101
2018-07-13 Added TPS62142 Buck U1 footprint
2018-07-13 Started work on microSD card footprint
2018-07-13 Added 3pin DIP switch footprint
2018-07-14 Corrected numbering on 3pin DIP Switch
2018-07-14 Added correct SD card footprint
2018-11-24 Added Wuerth Micro USB connector footprint to haathi lib
2018-11-24 TL3305 tactile sw footprint
2018-11-24 USB connector changed to be compatible with 6 pin Wurth one
    [haathi_usb.sch]
2018-11-24 Added footprints for Barrel jack, pinheaders, jtag
2018-11-24 SPDT switch footprint
